rares0andr/Tone-corrector-audio-preamp/Proiect docs/gerber.jpg

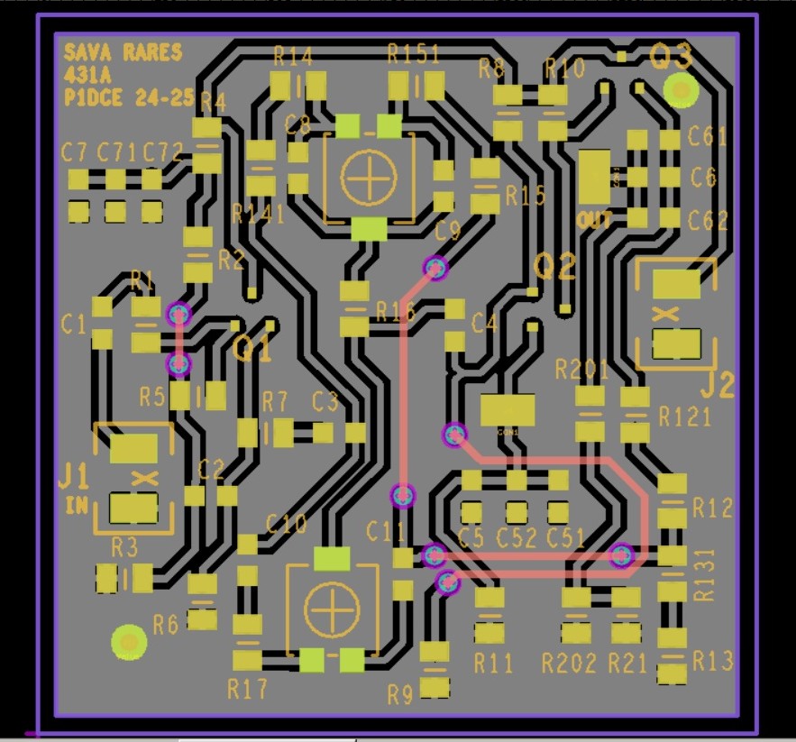
Proiect docs/gerber.jpg
