rares0andr/Tone-corrector-audio-preamp/Proiect docs/pcb.jpg

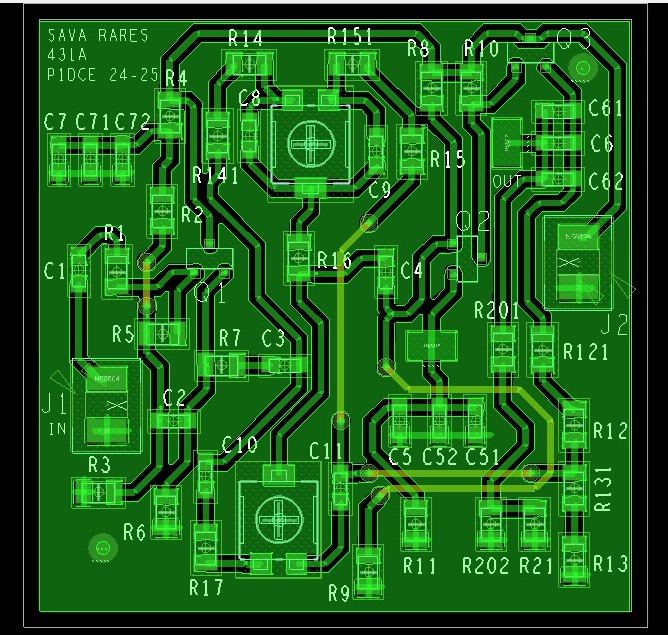
Proiect docs/pcb.jpg
