rares0andr/Tone-corrector-audio-preamp/Schematics/lib_modeleSpice/Lib_ModelePSpice_Anexa_1/Modele SPICE LED 2022/Tabel_LED-uri.png

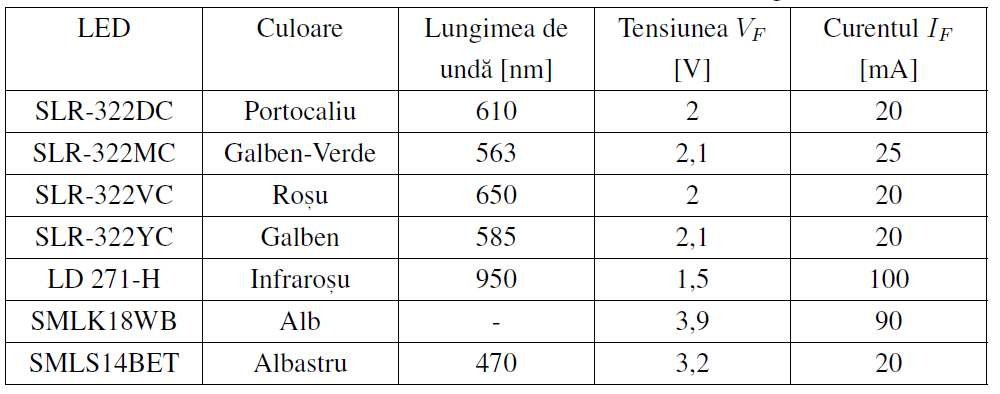
Schematics/lib_modeleSpice/Lib_ModelePSpice_Anexa_1/Modele SPICE LED 2022/Tabel_LED-uri.png
