rares0andr/Tone-corrector-audio-preamp/Simulations/frecv 0.01 0.5.jpg

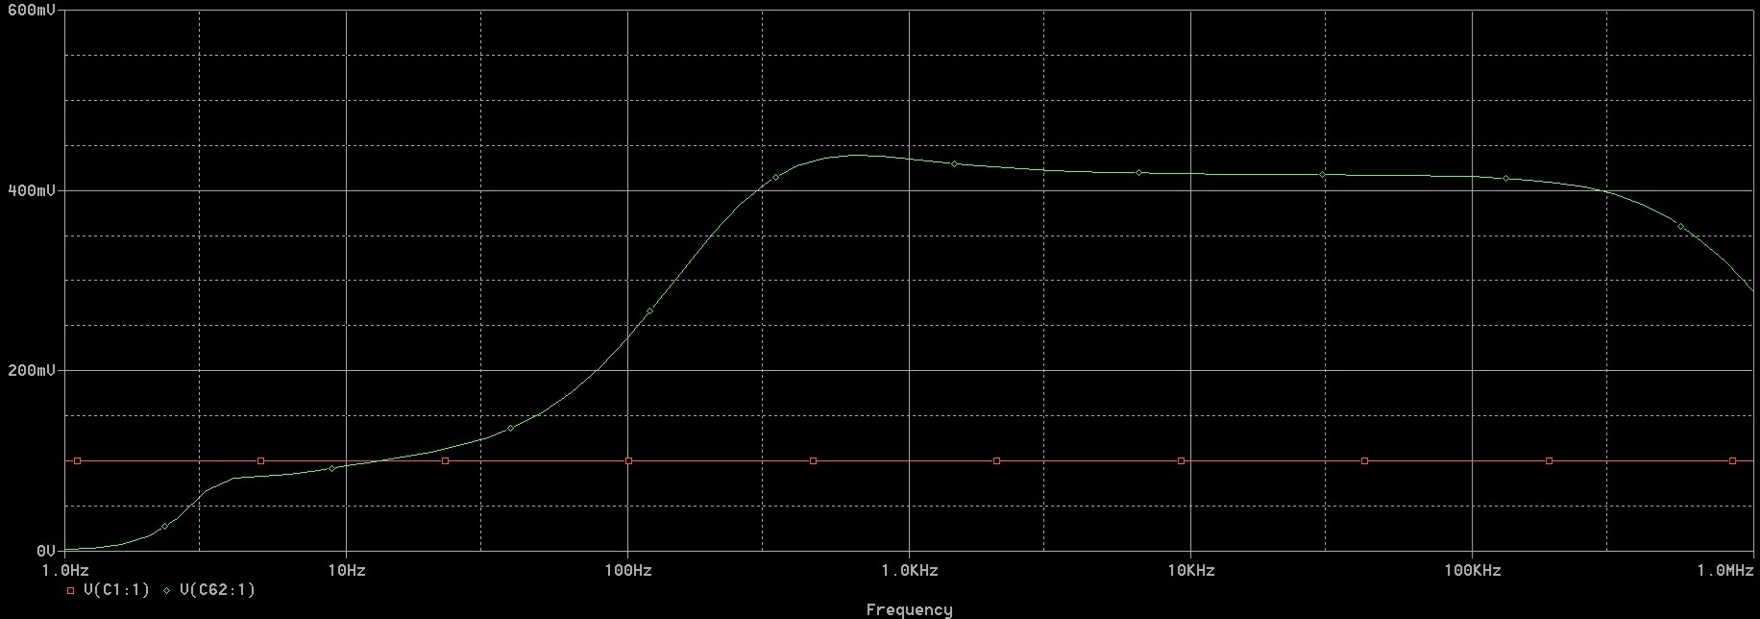
Simulations/frecv 0.01 0.5.jpg
