rares0andr/Tone-corrector-audio-preamp/(list of files, drawings)

Other design files:
Schematics/lib_modeleSpice/Lib_ModelePSpice_Anexa_1/Modele_A1_lib/1N4148.OLB
Schematics/lib_modeleSpice/Lib_ModelePSpice_Anexa_1/Modele_A1_lib/1n4148.opj
Schematics/lib_modeleSpice/Lib_ModelePSpice_Anexa_1/Modele_A1_lib/BC807-25.OLB
Schematics/lib_modeleSpice/Lib_ModelePSpice_Anexa_1/Modele_A1_lib/bc807-25.opj
Schematics/lib_modeleSpice/Lib_ModelePSpice_Anexa_1/Modele_A1_lib/BC817-25.OLB
Schematics/lib_modeleSpice/Lib_ModelePSpice_Anexa_1/Modele_A1_lib/bc817-25.opj
Schematics/lib_modeleSpice/Lib_ModelePSpice_Anexa_1/Modele_A1_lib/BC846B.OLB
Schematics/lib_modeleSpice/Lib_ModelePSpice_Anexa_1/Modele_A1_lib/BC856B.OLB
Schematics/lib_modeleSpice/Lib_ModelePSpice_Anexa_1/Modele_A1_lib/BZX84C2V7.OLB
Schematics/lib_modeleSpice/Lib_ModelePSpice_Anexa_1/Modele_A1_lib/BZX84C5V1.OLB
Schematics/lib_modeleSpice/Lib_ModelePSpice_Anexa_1/Modele_A1_lib/BZX84C5V6.OLB
Schematics/lib_modeleSpice/Lib_ModelePSpice_Anexa_1/Modele_A1_lib/BZX84C6V2.OLB
Schematics/lib_modeleSpice/Lib_ModelePSpice_Anexa_1/Modele_A1_lib/BZX84C6V8.OLB
Schematics/lib_modeleSpice/Lib_ModelePSpice_Anexa_1/Modele_A1_lib/BZX84C10.OLB
Schematics/lib_modeleSpice/Lib_ModelePSpice_Anexa_1/Modele_A1_lib/IRFR120NPBF.OLB
Schematics/lib_modeleSpice/Lib_ModelePSpice_Anexa_1/Modele_A1_lib/MJD31CG.OLB
Schematics/lib_modeleSpice/Lib_ModelePSpice_Anexa_1/Modele_A1_lib/MJD32CG.OLB
Schematics/lib_modeleSpice/Lib_ModelePSpice_Anexa_1/Modele_A1_lib/MMBFJ177LT1G.OLB
Schematics/lib_modeleSpice/Lib_ModelePSpice_Anexa_1/Modele_A1_lib/MMBFJ309LT1G.OLB
Schematics/SCHEMA_ELECTRONICA.DSN
Schematics/schema_electronica.opj
